AndrewRobotics/Cube_3D8/01_Manuals/1.png

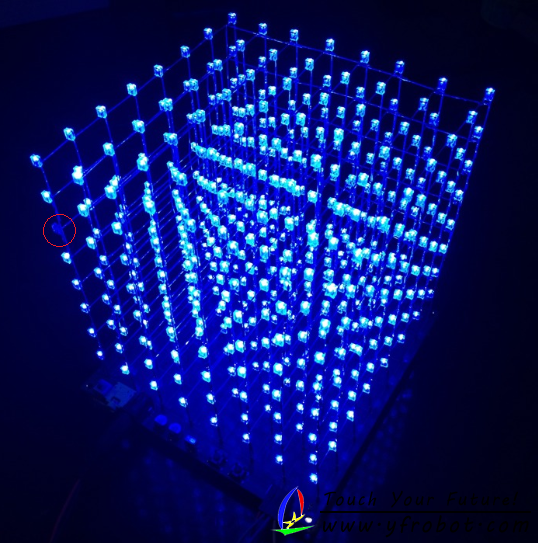
01_Manuals/1.png
