AndrewRobotics/Cube_3D8/01_Manuals/3.png

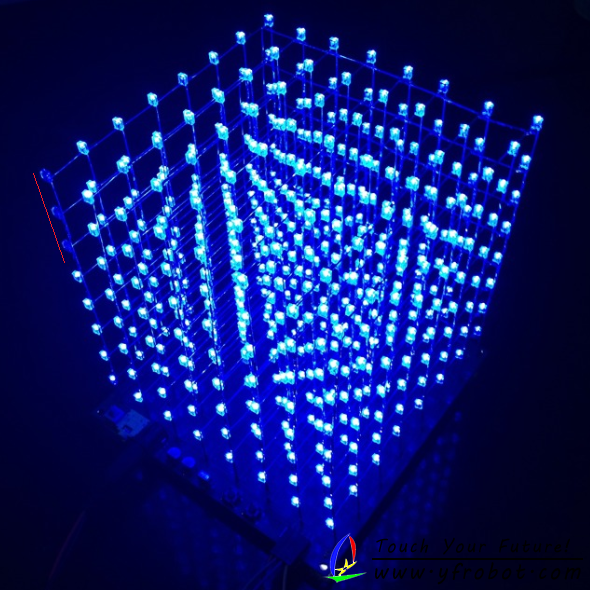
01_Manuals/3.png
