AndrewRobotics/Cube_3D8/README.md

# Cube 3D8

Cube 3D8 Author files collection.
