AndrewRobotics/Cube_3D8/03_Programs/windows/YFRobot Magic-LightCube/readme.txt

****************************动画数组储存文件夹******************************

**********************************YFROBOT***********************************
