AndrewRobotics/Cube_3D8/03_Programs/windows/YFRobot Magic-LightCube/MagicCubeV2.3.png

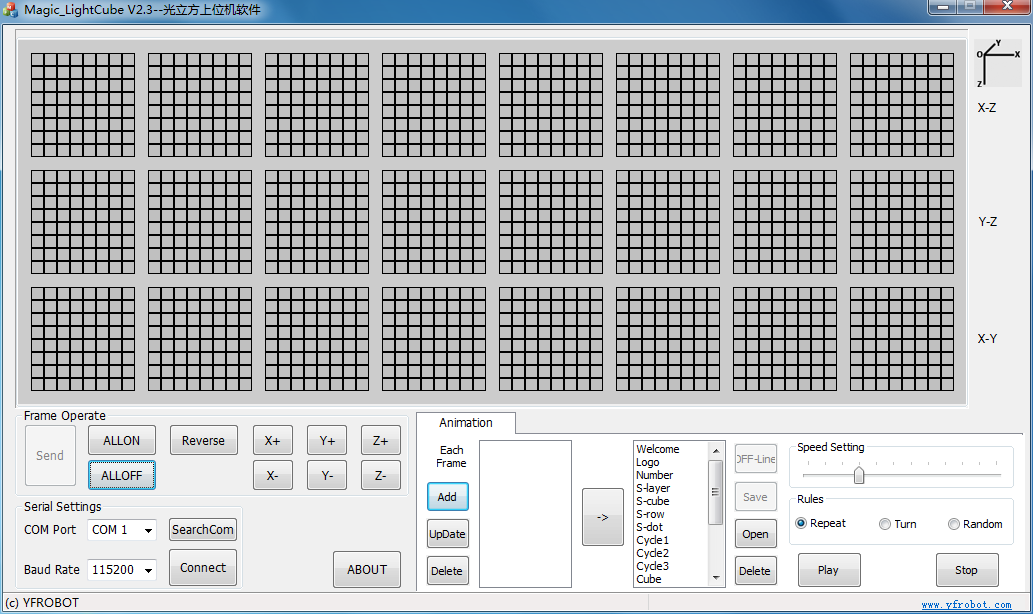
03_Programs/windows/YFRobot Magic-LightCube/MagicCubeV2.3.png
