AndrewRobotics/Cube_3D8/01_Manuals/cube8V1.1 schematic.pdf

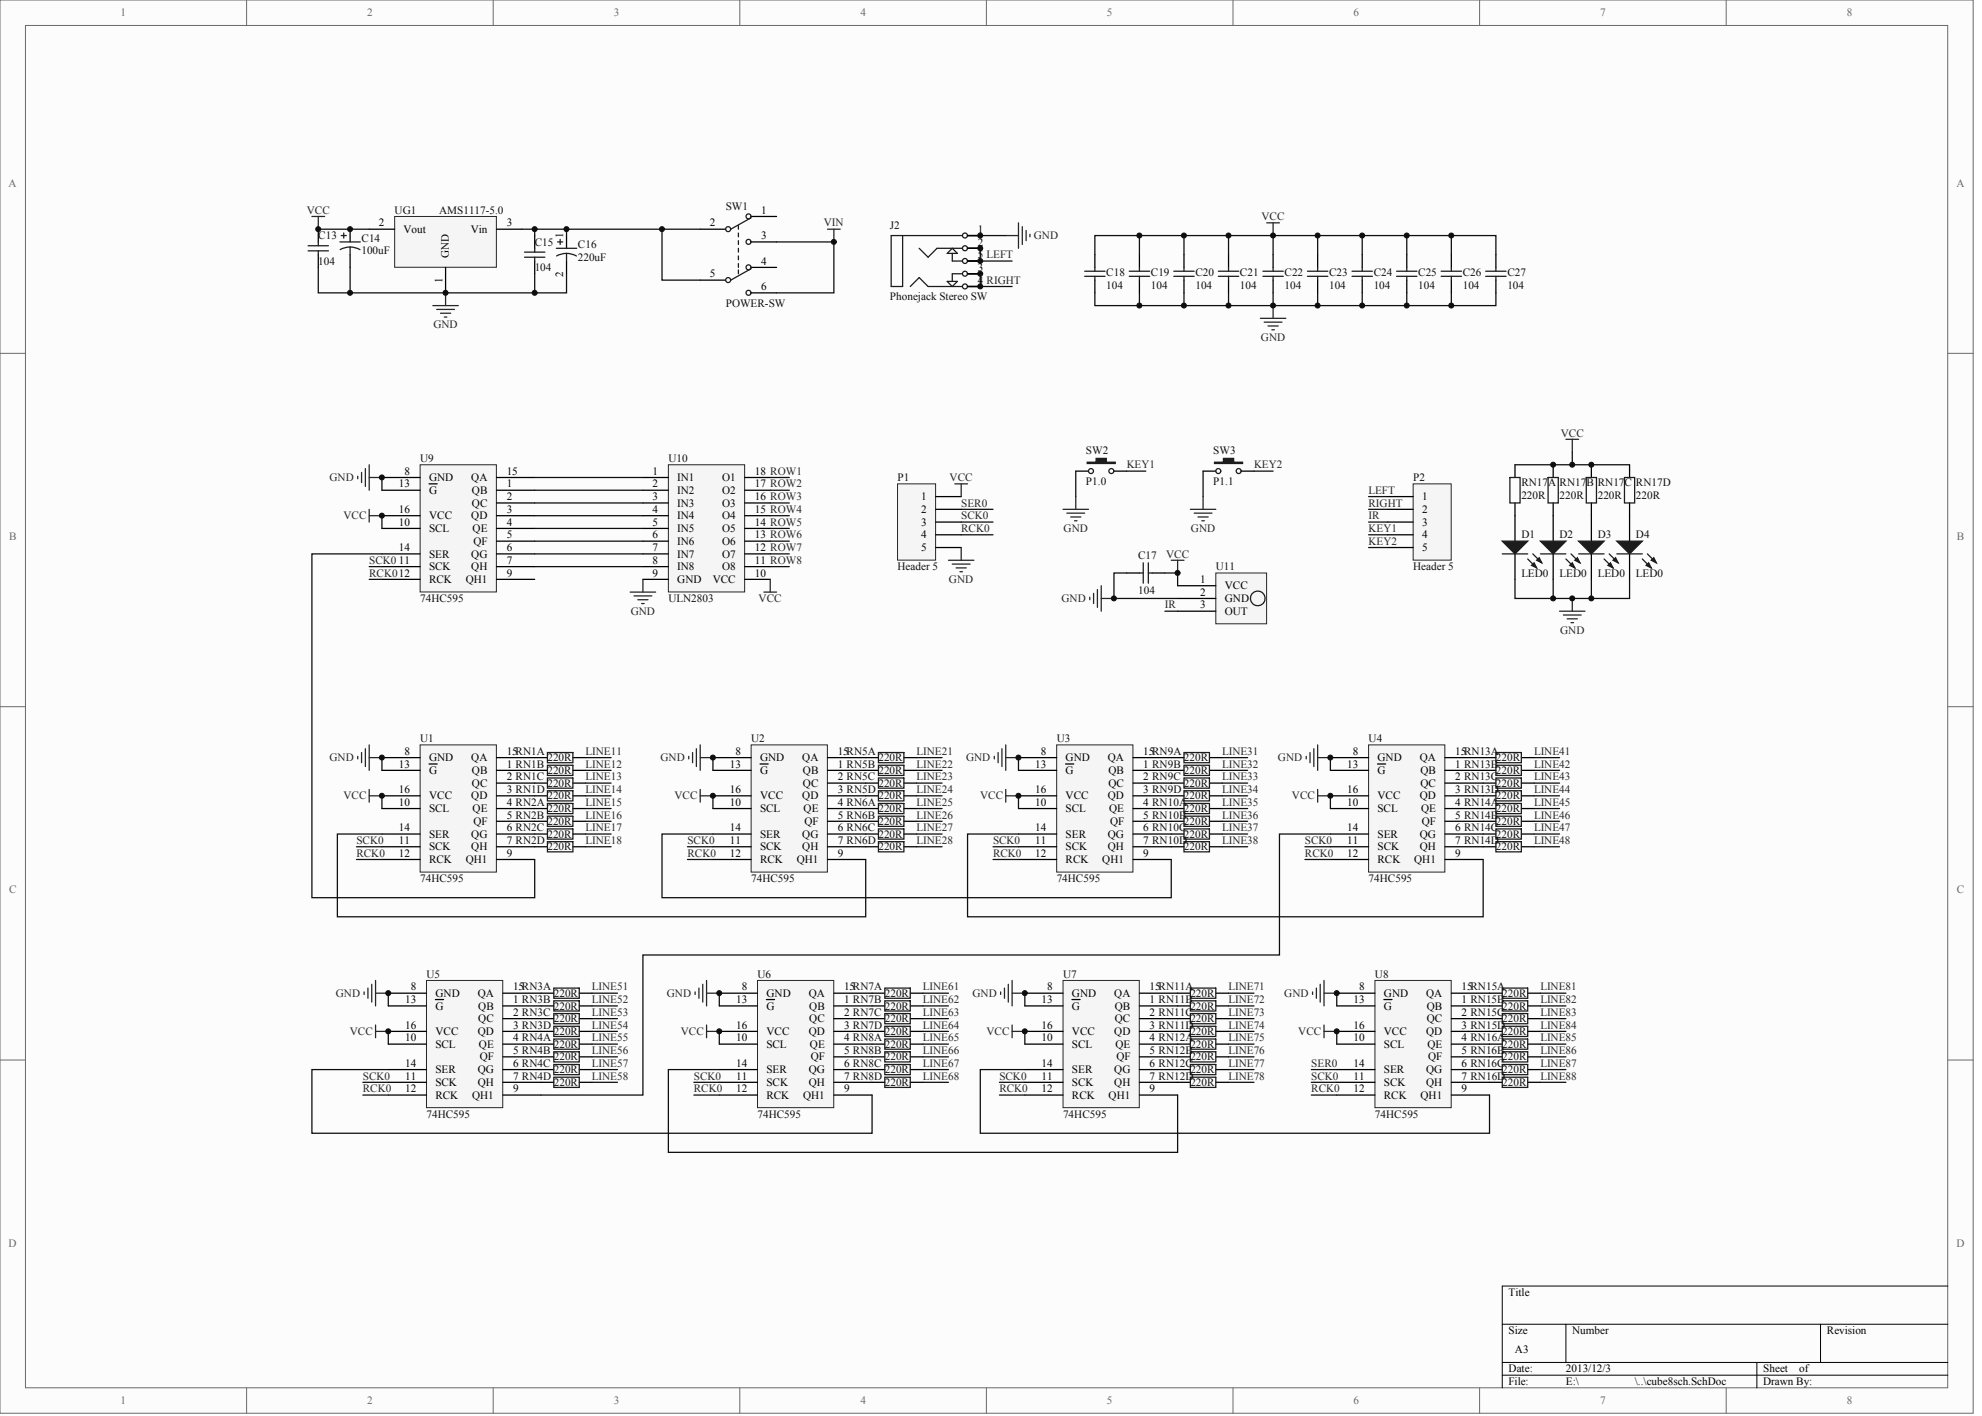
[picture p26: page 1]

QH1 QH RCK 12 | P0U107 P0U107 P0U107 7 9 SCK 11 | QH1 QH RCK 12 | P0U207 P0U207 P0U207 7 9 SCK 11 | P0U3011 P0U3012 | QH1 QH RCK 12 | P0U307 P0U307 P0U307 7 9 SCK 11 | P0U4011 P0U4012 | QH1 QH RCK 12 | P0U407 P0U407 P0U407 7 9 SCK 11
