AndrewRobotics/Cube_3D8/03_Programs/src/Magic_LightCube/Magic_LightCube/Resource.h

//{{NO_DEPENDENCIES}}
// Microsoft Visual C++ generated include file.
// Used by Magic_LightCube.rc
//
#define IDM_ABOUTBOX                    0x0010
#define IDD_ABOUTBOX                    100
#define IDS_ABOUTBOX                    101
#define IDD_Magic_LightCube_DIALOG                102
#define IDR_MAINFRAME                   128
#define IDD_ANIMATION_DIALOG            143
#define IDD_MUSIC_DIALOG                144
#define IDD_SAVE_DIALOG                 147
#define IDB_BITMAP1                     148
#define IDB_BITMAP2                     149
#define IDB_BITMAP3                     150
#define IDB_BITMAP5                     156
#define IDC_BUTTON_ALLOFF               1002
#define IDC_BUTTON_ALLON                1003
#define IDC_STATIC_PIC                  1004
#define IDC_EDIT_ARRAY                  1005
#define IDC_TAB1                        1006
#define IDC_SLIDER1                     1007
#define IDC_SLIDER2                     1008
#define IDC_BUTTON1                     1009
#define IDC_BUTTON_CONNECT              1009
#define IDC_BUTTON_SAVE1                1009
#define IDC_MSCOMM1                     1011
#define IDC_RADIO1                      1012
#define IDC_RADIO2                      1013
#define IDC_RADIO3                      1014
#define IDC_COMBO_COM                   1018
#define IDC_COMBO_BAUD                  1019
#define IDC_BUTTON_SEND                 1020
#define IDC_LIST_STATIC                 1023
#define IDC_LIST_ANIMATION              1026
#define IDCANCEL_SAVE                   1028
#define IDC_EDIT_NAME                   1029
#define IDOK_SAVE                       1030
#define IDC_BUTTON_SAVE2                1031
#define IDC_BUTTON2                     1032
#define IDC_BUTTON_TEST                 1032
#define IDC_BUTTON_DELETE1              1032
#define IDC_STATIC_MUSIC                1034
#define IDC_BUTTON_STOP                 1035
#define IDC_CHECK_KEEP                  1036
#define IDC_SLIDER_SPEED                1037
#define IDC_BUTTON_DELETE2              1038
#define IDC_BUTTON_UPDATE1              1039
#define IDC_BUTTON_OPEN                 1042
#define IDC_EDIT2                       1044
#define IDC_STATIC_EACH                 1045

// Next default values for new objects
// 
#ifdef APSTUDIO_INVOKED
#ifndef APSTUDIO_READONLY_SYMBOLS
#define _APS_NEXT_RESOURCE_VALUE        159
#define _APS_NEXT_COMMAND_VALUE         32771
#define _APS_NEXT_CONTROL_VALUE         1046
#define _APS_NEXT_SYMED_VALUE           101
#endif
#endif
